pramitpal/4x8bit_DAC_ADC/ADC_DAC/README.MD

multiplexed ADC/DAC block with 4x8bit Potentiometric DAC & 4x 8-bit ADCs
