pramitpal/4x8bit_DAC_ADC/_OLD_DATA/sky130_fd_pr/cells/special_nfet_pass_lvt/sky130_fd_pr__special_nfet_pass_lvt.bins.csv

device | bin | W | L
sky130_fd_pr__special_nfet_pass_lvt | 0 | 0.3 | 0.15
