pramitpal/4x8bit_DAC_ADC/All_layouts/simulation/2.PNG

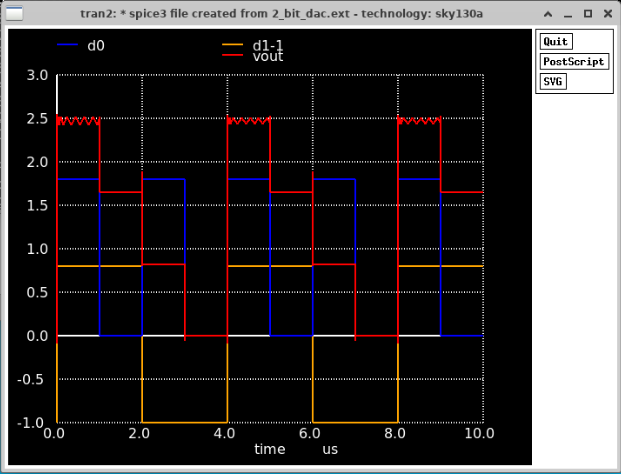
All_layouts/simulation/2.PNG
