pramitpal/4x8bit_DAC_ADC/All_layouts/simulation/2x8bit_tx_buffer.PNG

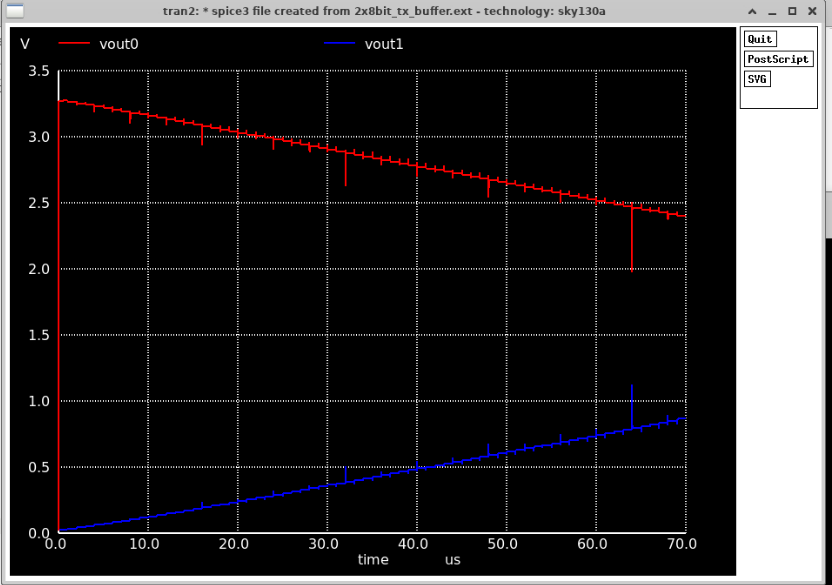
All_layouts/simulation/2x8bit_tx_buffer.PNG
