pramitpal/4x8bit_DAC_ADC/All_layouts/simulation/3.PNG

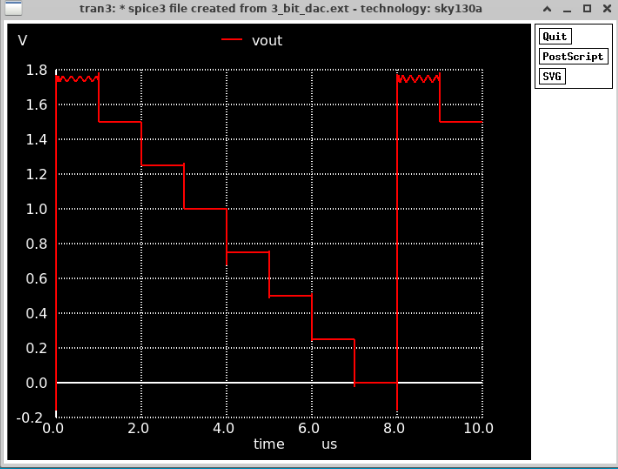
All_layouts/simulation/3.PNG
