pramitpal/4x8bit_DAC_ADC/All_layouts/simulation/4.PNG

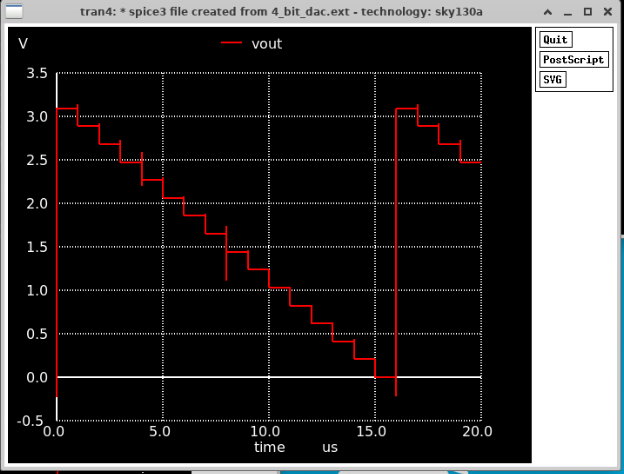
All_layouts/simulation/4.PNG
