pramitpal/4x8bit_DAC_ADC/All_layouts/simulation/5.PNG

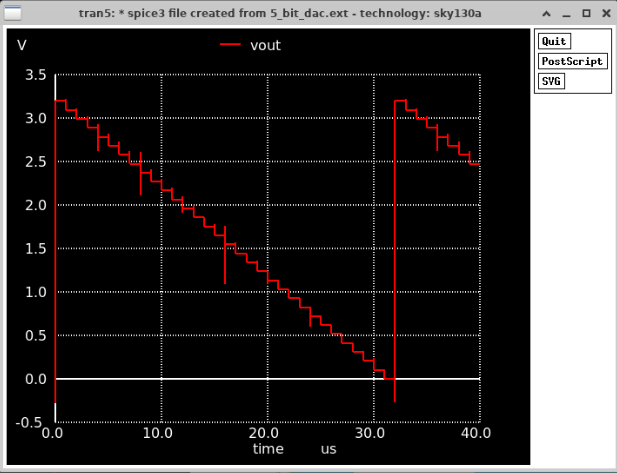
All_layouts/simulation/5.PNG
