pramitpal/4x8bit_DAC_ADC/All_layouts/simulation/7.PNG

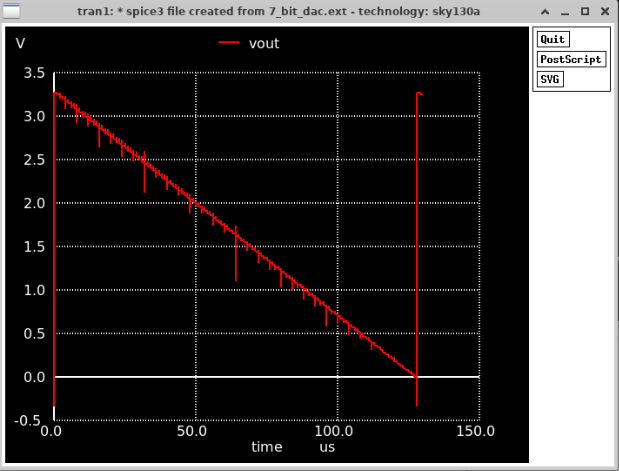
All_layouts/simulation/7.PNG
