pramitpal/4x8bit_DAC_ADC/All_layouts/simulation/dac_top_sim.PNG

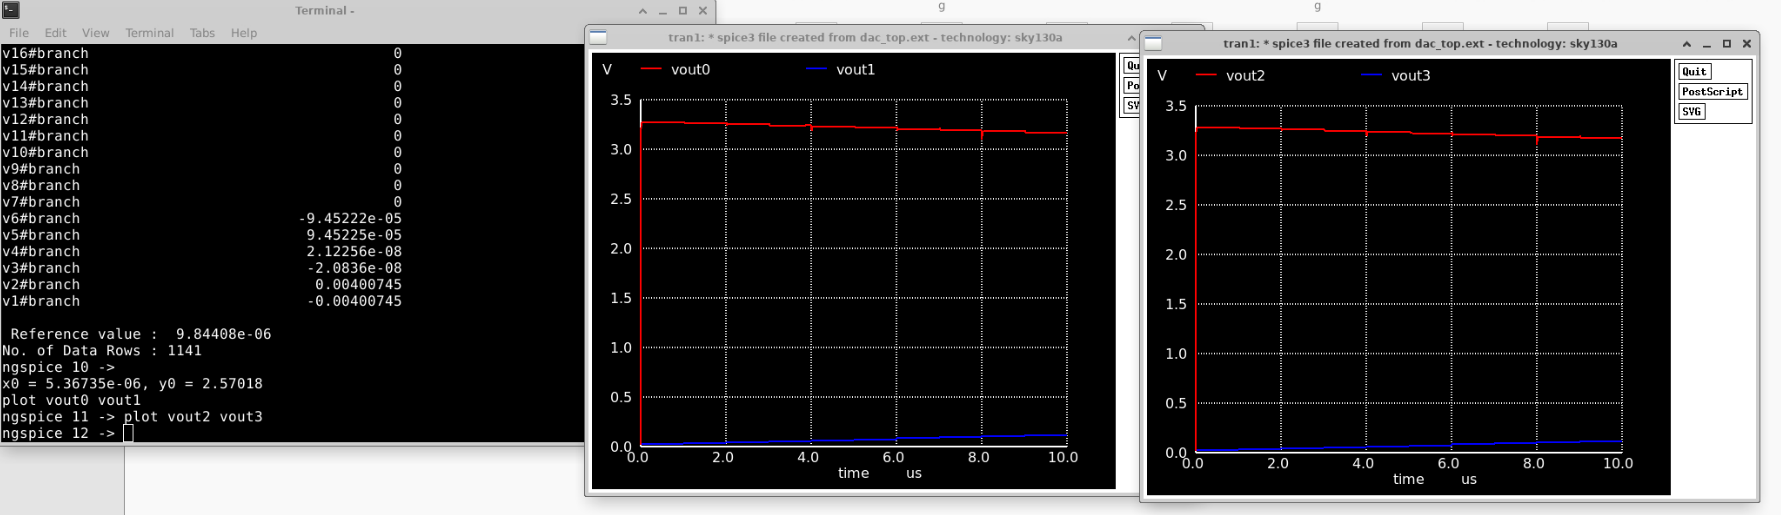
All_layouts/simulation/dac_top_sim.PNG
