pramitpal/4x8bit_DAC_ADC/Comparator/references/34_2020_1371_Fig3_HTML.png

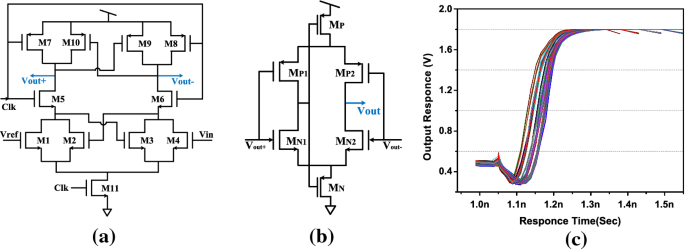
Comparator/references/34_2020_1371_Fig3_HTML.png
