pramitpal/4x8bit_DAC_ADC/Comparator/references/495133_1_En_42_Fig1_HTML.png

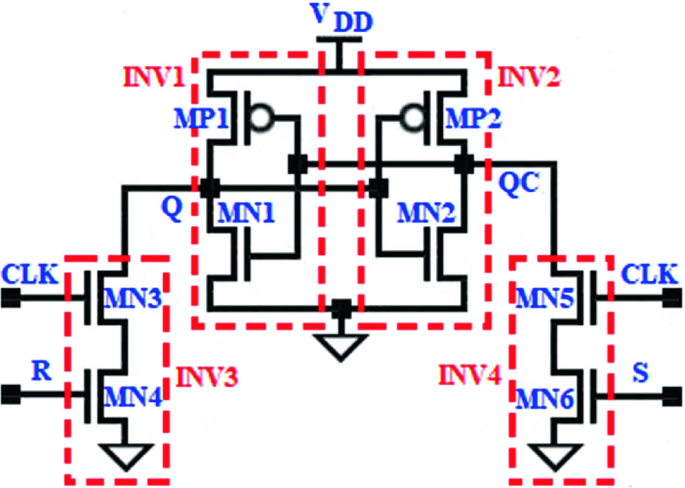
Comparator/references/495133_1_En_42_Fig1_HTML.png
