pramitpal/4x8bit_DAC_ADC/correct_LEF_files.png

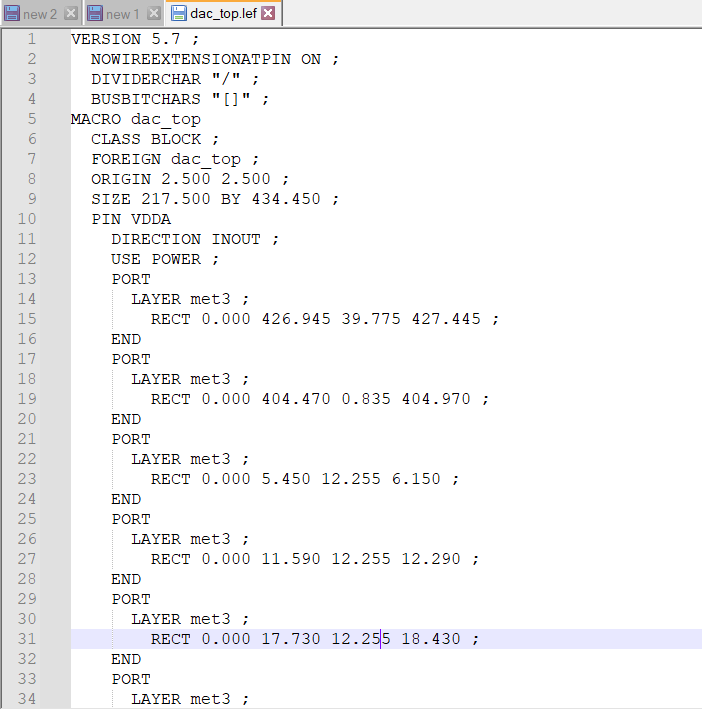
correct_LEF_files.png
