pramitpal/4x8bit_DAC_ADC/Mux/Postlayout/Spice/transient_analysis.PNG

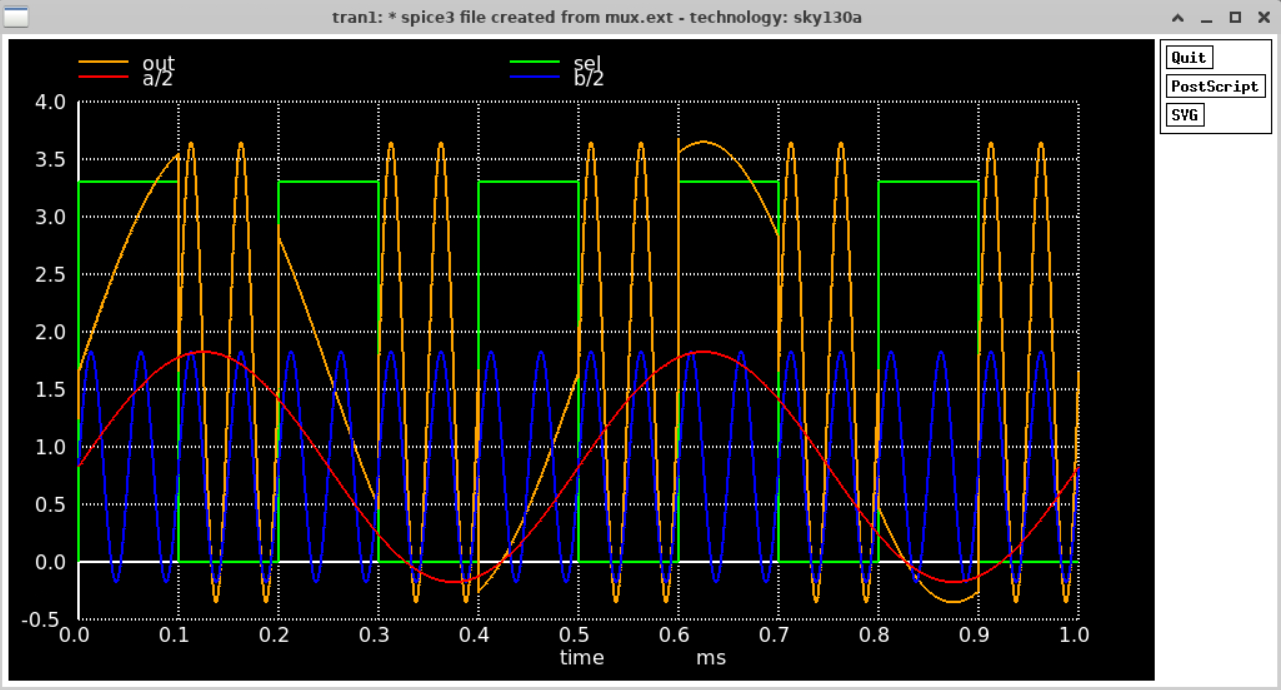
Mux/Postlayout/Spice/transient_analysis.PNG
