pramitpal/4x8bit_DAC_ADC/sample_hold/postlayout/simulation/postlayout.PNG

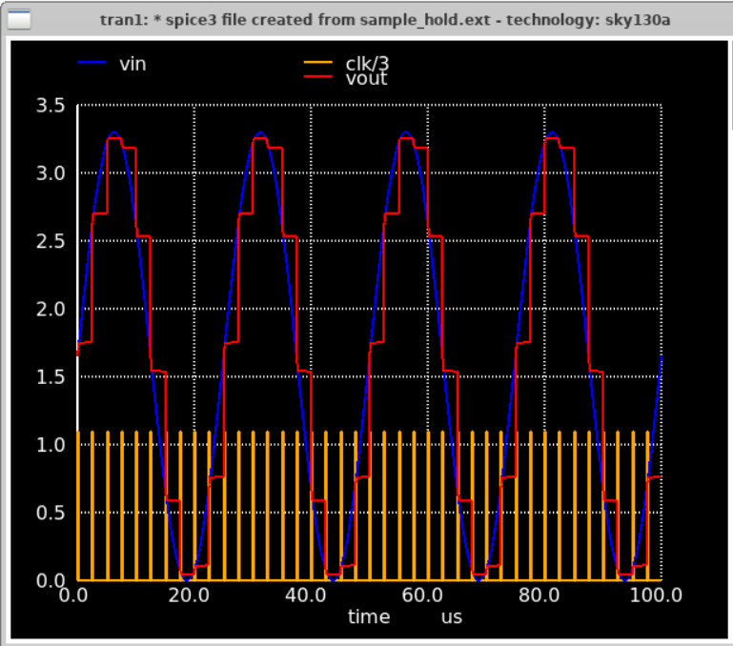
sample_hold/postlayout/simulation/postlayout.PNG
