pramitpal/4x8bit_DAC_ADC/sample_hold/schematic/prelayout.PNG

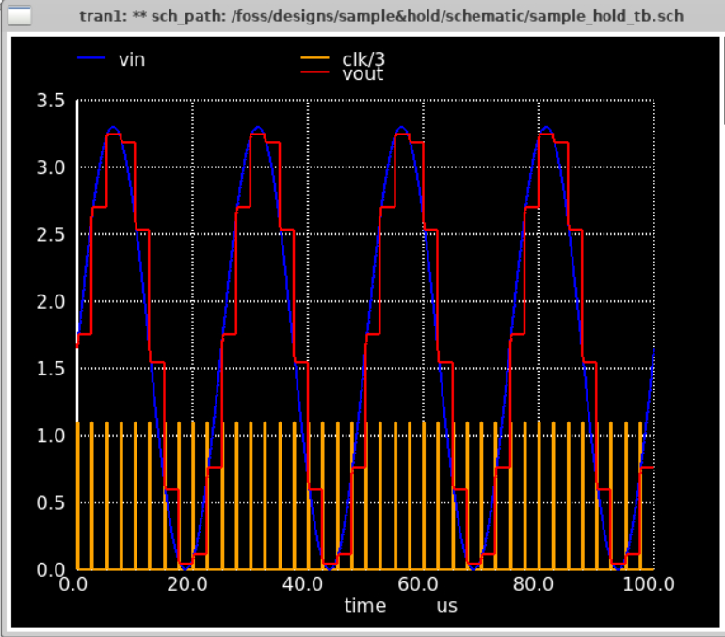
sample_hold/schematic/prelayout.PNG
