pramitpal/4x8bit_DAC_ADC/vnc_start_script_setting.png

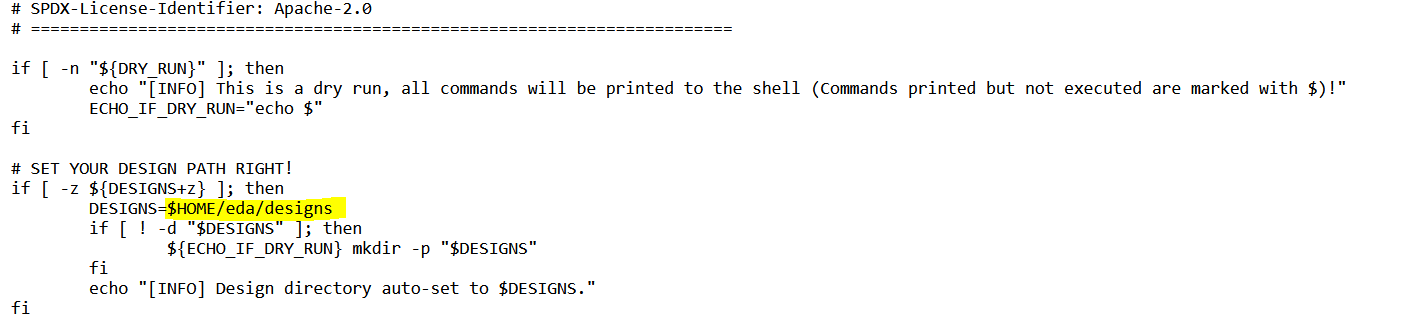
vnc_start_script_setting.png
