pramitpal/4x8bit_DAC_ADC/_OLD_DATA/sky130_fd_pr/cells/rf_pfet_01v8_mvt/sky130_fd_pr__rf_pfet_01v8_mvt_aF02W0p84L0p15.netlist.tsv

sky130_fd_pr__rf_pfet_01v8_mvt_aF02W0p84L0p15 | BULK:? DRAIN:? GATE:? SOURCE:?
Name | Formula | techLibCellName | nd | ng | ns | nb | mname | w | l | m
 |  | -1
M1 | MOSFET |  | DRAIN | GATE | SOURCE | BULK | model_use_only | 0.84 | 0.15 | 1
M2 | MOSFET |  | DRAIN | GATE | SOURCE | BULK | model_use_only | 0.84 | 0.15 | 1
