pramitpal/4x8bit_DAC_ADC/Comparator/schematic/self_calibrating/Readme.md

## self calibrating 3.3v rail to rail comparator (sigma=1mv)
Yet to do the mismatch simulations
