pramitpal/4x8bit_DAC_ADC/(list of files, drawings)

Other design files:
Layout_v2/Post-layout/gds/sky130A.lyt
