pramitpal/4x8bit_DAC_ADC/(commit log)

2023-06-11 added new layouts
    [sky130A.lyt]
2023-06-18 added dac_top and gds, checked drc
    [sky130A.lyt]
2023-06-19 added lef spice and svg files
    [2_bit_dac.sch, opamp.sch]
2023-06-23 added all schematics
    [2_bit_dac.sch, 3_bit_dac.sch, 4_bit_dac.sch, 5_bit_dac.sch, 6_bit_dac.sch, 7_bit_dac.sch, 8_bit_dac.sch, dac_top.sch]
2023-06-28 added new lvs and added full_RCX
    [2_bit_dac.sch, 3_bit_dac.sch, 4_bit_dac.sch, 5_bit_dac.sch, 6_bit_dac.sch, 7_bit_dac.sch, 8_bit_dac.sch, dac_top.sch]
2023-06-29 updated lvs folder
    [2_bit_dac.sch, 3_bit_dac.sch, 4_bit_dac.sch, 5_bit_dac.sch, 6_bit_dac.sch, 7_bit_dac.sch, 8_bit_dac.sch, dac_top.sch]
2023-06-30 added opamp lvs clear log
    [opamp.sch]
2023-06-30 updated opamp schematic
    [opamp.sch]
2023-07-04 added comparator schematic and paper
    [SR_latch.sch, buf.sch, miyahara_comparator.sch, miyahara_comparator_testbench.sch]
2023-07-05 fixed 6bit and 8bit lvs cleared
    [2_bit_dac.sch, 3_bit_dac.sch, 4_bit_dac.sch, 5_bit_dac.sch, 6_bit_dac.sch, 7_bit_dac.sch, 8_bit_dac.sch, dac_top.sch]
2023-07-06 fixed and cleared all lvs
    [2_bit_dac.sch, 3_bit_dac.sch, 4_bit_dac.sch, 4x8_bit_dac.sch, 5_bit_dac.sch, 6_bit_dac.sch, 7_bit_dac.sch, 8_bit_dac.sch]
2023-07-09 added new comparator and dnl inl measurement
    [EPC.sch, EPC_testbench.sch, SR_latch.sch, buf.sch, delay_cell.sch, miyahara_comparator.sch, miyahara_comparator_testbench.sch, nand.sch]
2023-07-11 added corrected DNL INL xlsx for 8bit
    [DNL_INL.xlsx]
2023-07-22 added new schematics
    [EPC.sch, EPC_testbench.sch, Mux.sch, Mux_tb.sch, comparator_testbench.sch, comparator_top.sch, delay_cell.sch, inverter.sch]
2023-07-31 new better comparator added
    [miyahara_comparator.sch]
2023-08-02 added best comparator_preamp stage
    [comparator_mine.sch, miyahara_comparator.sch]
2023-08-04 working comparator schematic, need tt_mm fixing
    [comparator_rail2rail_working.sch]
2023-08-08 Add files via upload
    with self calibration
    [c.sch]
2023-08-11 static good performance
    [tb_comparator.sch]
2023-08-20 sample_hold all done
    [inverter.sch, inverter_tb.sch, sample_hold.sch, sample_hold_tb.sch, untitled.sch]
2023-09-03 high_gain folded cascode comparator
    [SR_latch.sch, buf.sch, c.sch, comparator_mine.sch, comparator_rail2rail_working.sch, comparator_testbench.sch, comparator_top.sch, cs.sch]
